cbm-instructions/thunderbirds/pictures/Hauptbild.jpg

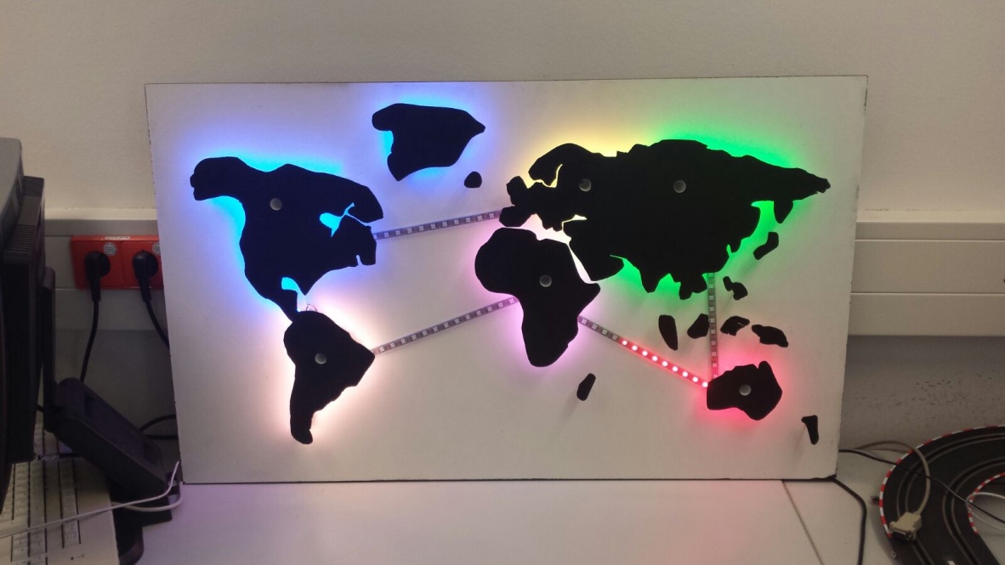
pictures/Hauptbild.jpg
